A-Loose-Screw/Levi/README.md

# Levi
Personal Robot Project

### Levi Robot:
Build Status (https://dev.azure.com/ConnorBuchel0890/A-Loose-Screw/_build/latest?definitionId=21&branchName=master)
### Robot Core Lib 
Build Status (https://dev.azure.com/ConnorBuchel0890/A-Loose-Screw/_build/latest?definitionId=22&branchName=master)
