A-Loose-Screw/Levi/Hardware/Levi-MotorController/Levi-MotorController.kicad_pcb

## KiCad design Hardware/Levi-MotorController/Levi-MotorController.kicad_pcb (2022-12-16, last stored version)

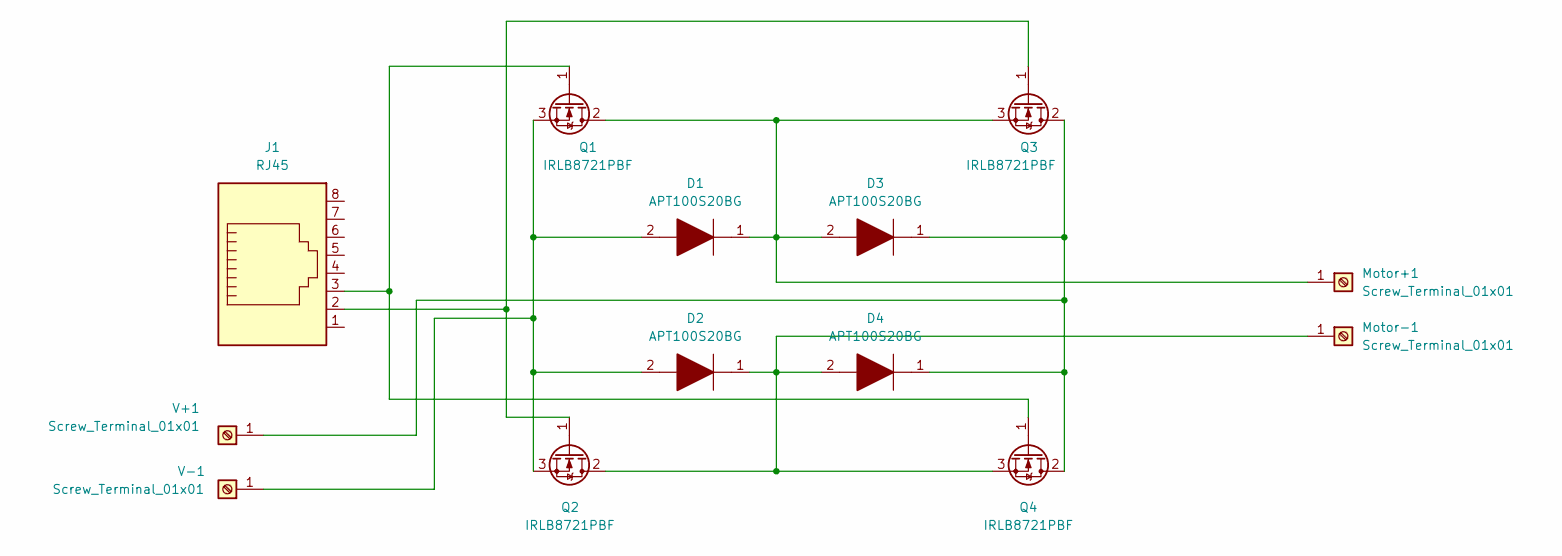
[picture p1: schematic Levi-MotorController.kicad_sch]

Parts:
D1, D2, D3, D4: APT100S20BG; TO1087P531X1588X2596-2P; Mouser Part Number 494-APT100S20BG
J1: RJ45; RJ45_Amphenol_RJHSE538X
Motor+1: Screw_Terminal_01x01; Wuerth_REDCUBE-THR_WP-THRSH_74651195_THR
Motor-1: Screw_Terminal_01x01; Wuerth_REDCUBE-THR_WP-THRSH_74651195_THR
Q1, Q2, Q3, Q4: IRLB8721PBF; TO-220-3_Horizontal_TabUp
V+1: Screw_Terminal_01x01; Wuerth_REDCUBE-THR_WP-THRSH_74651195_THR
V-1: Screw_Terminal_01x01; Wuerth_REDCUBE-THR_WP-THRSH_74651195_THR

Connections:
unnamed: D1.1, D3.2, Motor+1.1, Q1.2 (D), Q3.3 (S)
unnamed: D2.1, D4.2, Motor-1.1, Q2.2 (D), Q4.3 (S)
unnamed: J1.2, Q2.1 (G), Q3.1 (G)
unnamed: J1.3, Q1.1 (G), Q4.1 (G)
unnamed: D1.2, D2.2, Q1.3 (S), Q2.3 (S), V-1.1
unnamed: D3.1, D4.1, Q3.2 (D), Q4.2 (D), V+1.1

Board: 2 copper layers, 13 parts (0 on the bottom side), 6 nets, no tracks yet.
