A-Loose-Screw/Levi/Levi/src/cpp/Main.cpp

/**
 * @file Main.cpp
 * @author Connor J Buchel (connorbuchel@gmail.com)
 * @brief Main for robot, passes robot class into RobotCore's singleton application class
 * @version 0.1
 * @date 2022-06-05
 * 
 * @copyright Copyright (c) 2022
 * 
 */

#include "Entry.h" // Don't touch this line
#include "Robot.h"
RBC_ROBOT_MAIN(Robot);
