A-Loose-Screw/Levi/(commit log)

2022-06-09 Switched remote for submodule
2022-08-03 Adding schematic
    [Levi-MotorController.kicad_pcb, Levi-MotorController.kicad_sch]
2022-08-04 adding footprints
    [Levi-MotorController.kicad_pcb, Levi-MotorController.kicad_sch]
2022-12-16 Added prototype motor controller
    [Levi-MotorController.kicad_pcb, Levi-MotorController.kicad_sch]
2022-12-20 Fixed up thread sleep issues on windows
    [Robot.cpp]
2023-01-29 removed hardware from code
    [Levi-MotorController.kicad_pcb, Levi-MotorController.kicad_sch]
